sinara-hw/AUX_PSU/README.md

# AUX_PSU
universal, low noise, 3-channel regulated power supply module 

## Design Files

Design files (schematics, PCB layouts, BOMs) can be found at [AUX_PSU/Releases](https://github.com/sinara-hw/AUX_PSU/releases).

## Wiki

More information can be found on the [wiki](https://github.com/sinara-hw/AUX_PSU/wiki).
