sinara-hw/AUX_PSU/(list of files, drawings)

Other design files:
AuxPowerSupply/AuxPowerSupply.PrjPcb
AuxPowerSupply/AuxPowerSupply.SchDoc
AuxPowerSupply/CPCIS_Connectors_P1.SchDoc
AuxPowerSupply/EEM_connector.SchDoc
AuxPowerSupply/Front_PowerConnectors.SchDoc
AuxPowerSupply/Negative_Rail.SchDoc
AuxPowerSupply/OverCurrent_Indicators.SchDoc
AuxPowerSupply/OverTempProtection.SchDoc
AuxPowerSupply/Positive_Rail.SchDoc
AuxPowerSupply/PowerConnectors.SchDoc
