sinara-hw/AUX_PSU/(threads)

Thread 1 (2020-01-10):

[RFC] Aux Power Supply

dtcallcock, 2020-01-10:
In my experience, lab setups rapidly acquire an armada of bench PSUs supplying the same old low voltage DC rails for misc homebrew electronics boxes.  Generally these PSUs are bulky, expensive, have much higher current spec than required, and sometimes have knobs on the front that get accidentally knocked with bad consequences.

It would be nice if there was a simple 3U, 4HP card capable of producing common low-current DC voltage rail combinations.  This board is fairly simple so the main question is probably whether enough people would find it useful and purchase it to make it worth while.

### Inputs
12V - via front panel barrel, rear Molex, and EEM

### Outputs
Voltage rail 1 - selectable between 3.3, 4, 5 and 6V - 1A
Voltage rail 2 - selectable between 5, 9, 12, 15, 18 V - 500mA
Voltage rail 3 - selectable between  -5, -9, -12, -15, -18 V - 500mA

Rotary switches to select voltage on each rail independently.  With a hex switch we can have 16 voltages per rail but a few obvious ones are listed above.

Rails generated using SMPS followed by LDO.

Specs in line with typical decent bench PSU.  Example spec taken from Keysight E3630A as a guide:

Load and line regulation: < 0.01% + 2 mV
Ripple and Noise (20 Hz to 20 MHz): < 350 μVrms, < 1.5 mVpp
Temperature coefficient per C: < 0.02% + 1 mV
Output Drift: Less than 0.1% + 5 mV
Transient response time: < 50 μsec following a change in output current from full load to half load for output to recover within: 15 mV

Overcurrent indicated by LED.  Rail would continue to operate (with no promises on spec) until thermal limit exceeded.  At which point thermal protection LED would come on and board would shut down.

### Connectors
M8-4 - A compact 4-pin connector - could fit 4/5 on panel.

Convenient pigtails [are available](https://www.digikey.com/product-detail/en/phoenix-contact/1406203/277-12862-ND/4291415) for ~$10.  Shielded versions also available for $20.

### Indicators
Overcurrent LED for each rail
Thermal protection LED

Edit: updated this top post to reflect discussion below

michalgaska, 2020-07-14:
I found other LDOs that are more suitable for our project. LT3089 and LT3090.
Both have a programmable current limit and output current monitor. LT3089 has also a junction temperature monitor.
I made output noise simulation for both devices:
LT3089:
There is no spice model for LT3089. Instead of a model for LT3089, I used the LT3081 model which is very similar.
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

LT3090:
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

gkasprow, 2020-07-16:
looks good!
@michalgaska What do you think by "more suitable" ?

gkasprow, 2021-05-22:
finished board
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

jordens, 2021-08-02:
@gkasprow Is this ready for production or has there been a run already?

gkasprow, 2021-08-02:
TS is currently producing it AFAIK

Closed 2021-05-22.

Thread 2 (2020-06-28):

Powering options/EEM

dtcallcock, 2020-06-28:
Options for getting 12V to power the board:

- Barrel connector on the front panel
- Molex connector on the back of the board
- EEM
- PoE

The first two seem like they definitely should.  I think the EEM is worth doing (like on clocker).  I don't think the PoE is, but mention it as it's become pretty standard in Sinara.

If EEM is implemented do we want the following features:
- A diode (ideal diode?) on the 12V line like Clocker to prevent [these kind of issues](https://github.com/sinara-hw/Stabilizer/issues/72).
- The usual EEPROM for identification via I2C (this wasn't done on Clocker).
- An I2C IO extender for monitoring overtemp/overcurrent/pgood etc.
- EEM to be located correctly for the CPCIS adaptor.

gkasprow, 2021-05-22:
I added the ideal diode protection

gkasprow, 2021-05-22:
we also have I2C ADC that monitors temperatures, currents, and voltages.
we don't have LDO PG to monitor.

Closed 2021-05-22.

Thread 3 (2020-07-14):

LDOs

dtcallcock, 2020-07-14:
I found other LDOs that are more suitable for our project. LT3089 and LT3090.
Both have a programmable current limit and output current monitor. LT3089 has also a junction temperature monitor.
I made output noise simulation for both devices:
LT3089:
There is no spice model for LT3089. Instead of a model for LT3089, I used the LT3081 model which is very similar.
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

LT3090:
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

_Originally posted by @michalgaska in https://github.com/sinara-hw/AUX_PSU/issues/1#issuecomment-658224245_

dtcallcock, 2020-07-14:
I made this its own issue to start breaking things out of the original RFC.

Compared to the TPS7A47-Q1, the LT3089 has somewhat worse specs:
- Output voltage noise: 27uVrms vs 4.2uVrms
- PSRR @ switcher freq: 40dB vs 60dB
- Dropout voltage: 1.5V vs 500mV

The latter would increase the power dissipated on this card by a couple of Watts at full draw.

However these aren't show stoppers (noise would still be better than typical bench PSU)  and might be a price worth paying for the convenient current monitor, temp monitor, and  programmable current limit.

gkasprow, 2020-07-16:
How precise is this current monitor? Of course it is simpler than just using the external sense resistor + opamps.

Closed 2021-05-22.

Thread 4 (2020-09-26):

schematic review

gkasprow, 2020-09-26:
- [x] NMOS won't work for a negative rail. Use PMOS + level shifters
- [x] add DC connector (the same as in Thermostat) on the rear edge to not force users to waste EEM slot
- [x] add LC filter between SMPS and LDO, they have not sufficient PSRR for switching frequency
- [x] resistors at the decoder outputs are not needed
- [x] rotate all strings, so the user doesn't need to set the Altium option that does it.
- [x] connect remaining ADC inputs to dividers measuring LDO outputs
- [x] add notes explaining current linit values and LED thresholds
- [x] Front panel LEDs need at least 1mA of current. Use same front panel LEDs current as other designs using same PNs.
- [x] are U sure the negative LDO produces positive ADC_Imon signal?
- [x] now the inactive switch positions result with max output voltages
- [x] use 8-position switches like[ this one](https://www.digikey.com/product-detail/en/S-8011/563-1054-ND/948365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). There is 3D model in Digikey.
- [x] assign all 8 positions, 3V and 6V is often needed. The rest of them must give known value. Place 0R resistors so the user can assign needed value.
- [x] add version with knob or some handle to the BOM. Vendors usually have such accessories, so the user has a choice. Changing the switch settings using a screwdriver will break the switch slot quickly.
- [x] alternatively, one can use [standard](https://pl.mouser.com/ProductDetail/NKK-Switches/NR01105ANG13-2A?qs=EU6FO9ffTwcM3pHNV2SdFA%3D%3D) 1:6 switch, but it would need a tiny RA adapter - a piece of PCB and RA 2.54 connector. But they are nearly 10$ per piece. However, they would last longer.
- [x] apply A3 template with WUT logo
- [x] connect all 3 connectors in the same manner. Place them on the top sheet. They will fit
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

gkasprow, 2020-09-26:
@dtcallcock @jbqubit @hartytp can you have a look at the schematics?
@michalgaska please place a PDF version to make review easier.

dtcallcock, 2020-10-21:
Any joy on the pdf?

jbqubit, 2021-02-26:
What's the status of this board? Searching for a schematic PDF still brings more tears than joy.

gkasprow, 2021-02-26:
@jbqubit here is the schematic. The output connector signal assignment will change.
[Aux_PSU.PDF](https://github.com/sinara-hw/AUX_PSU/files/6052347/Aux_PSU.PDF)

gkasprow, 2021-02-26:
It goes to production together with SHuttler boards

michalgaska, 2021-02-27:
I committed the current design files.
Schematic:
[AuxPowerSupply.pdf](https://github.com/sinara-hw/AUX_PSU/files/6053862/AuxPowerSupply.pdf)

dtcallcock, 2021-03-05:
- It's a bit odd one of the OC LEDs is green, not red.  I guess it would add a BOM line though.

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

- I think it'd be much more useful to have all 3 voltages plus ground on each output connector instead of one voltage on each connector.

- The rear power connector is barrel right now.  I thought the Molex type was the preferred population option for internal power connectors though.

gkasprow, 2021-03-05:
> I think it'd be much more useful to have all 3 voltages plus ground on each output connector instead of one voltage on each connector.
>The rear power connector is barrel right now. I thought the Molex type was the preferred population option for internal power connectors though.
>It's a bit odd one of the OC LEDs is green, not red. I guess it would add a BOM line though.

are you looking at the right schematic? This was fixed some time ago...

dtcallcock, 2021-03-05:
My bad - clicked wrong link above.

- My comment about the Molex still stands though - shouldn't it have a dual footprint like on Stabilizer:
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

- Can we get an annotation about the OC setpoints and programmed regulator current limits?  Right now it looks like the positive rails are set to 600mA limit with 500mA OC threshold but the negative rail is 500mA/500mA.

- As the second positive rail is typically used for V_DD, would 1.8 and 2.5 options be more useful than 15 and 18?  It might be nice to trade the lower voltages for more current in this way too.  Could the limit be raised on this rail if the higher voltages aren't an option?  It looks like going above 800mA would involve paralleling a second LDO so that's perhaps not worth it.

- Why does the temperature sensor only shut off the negative rail?

- Can a 0R be added between the M8-4 shield and ground?  That would allow one to depopulate this if they wanted the shield connected at the load only.  Without being able to see the M8-4 part number, I cannot tell if the shield is likely to be isolated from the front panel.  If it isn't that probably rules this use case out.  However in that case, I think you still want the 0R as you need it to be able to isolate the front panel.

gkasprow, 2021-05-22:
I implemented all suggestions

dtcallcock, 2021-05-24:
Can you make a release with pdf if you have a min?

gkasprow, 2021-05-25:
done

Closed 2021-05-22.

Thread 5 (2021-05-22):

Panel

gkasprow, 2021-05-22:
Here is proposed front panel design
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

dtcallcock, 2021-05-24:
This panel contains there naming conventions -> (+1, +2, -1), (1+, 2+ 1-), and (CH1, CH2, NEG).  Perhaps stick to one?  It's still fairly clear so not a big deal.

Could the labels around the M8-4s be placed at 2, 4, 8, and 10 o'clock around the connector holes such that they actually label the pins?

gkasprow, 2023-02-10:
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

Thread 7 (2021-07-01):

[Schematic review] BCD-2-Decimal decoder floating inputs

mkiepiela, 2021-07-01:
Don't leave the unused D inputs of CD4028 (U3, U4 and U5) floating.
They should be tied to logic Low (N3V3 for U3, GND for U4 and U5).

gkasprow, 2021-07-01:
ACK

Closed 2021-07-01.

Thread 8 (2021-07-01):

[Schematic review] T28 always open

mkiepiela, 2021-07-01:
What is the purpose of T28?
It will be always open, regardless if Kasli is connected or not (P3V3_MP exists or not).

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

gkasprow, 2021-07-01:
It's a voltage translator

mkiepiela, 2021-07-01:
Take a look at this once again, please. It does not look like voltage translator.
P-MOS will be always open. On the En line will be more than 8V (R57/R98 voltage divider additionally pulled up by R64 and LD1D).

gkasprow, 2021-08-18:
Right! There should be NMOS. I didn't notice that PMOS was used instead

Closed 2021-08-18.

Thread 9 (2021-07-01):

[Schematic review] Temperature sensor - to high voltage at O.S. output

mkiepiela, 2021-07-01:
Voltage at O.S. pin of LM75 (IC14) must be less than 6.5V.
It is exceeded. Except R57/R98 voltage divider, this net is also pulled up by R64, LD1D (and open T28).

gkasprow, 2021-07-01:
that's the role of T28 to make sure the rail won't exceed 3V3

mkiepiela, 2021-07-01:
Doesn't seem to work. Details:
https://github.com/sinara-hw/AUX_PSU/issues/8

gkasprow, 2021-08-18:
that should work
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

Closed 2021-08-18.

Thread 10 (2021-08-31):

Stock problems

pkozakiewicz, 2021-08-31:
I would like to address some availability problems:

LT3090HMSE#PBF - can we use different temperature range version? (EMSE, IMSE),
LT8362IDD#TRPBF - same as above (EDD),
LM75AIMM/NOPB - is there any 1:1 replacement?

gkasprow, 2021-08-31:
Yes, you can use another temp range.
LM75BIM-5/NOPB would work

pkozakiewicz, 2021-09-23:
These are another two shortages:

1SMB5916BT3G
3059Y-1-254LF

martafafara, 2024-10-09:
Most of above parts had only temporary stock problems, except LM75AIMM/NOPB which is obsolete. TI recommended replacement: LM75AIMMX/NOPB.
Detailed analysis of BOM revealed additional necessary changes:
CD4028BM-> CD4028BM96
GRM219R61E106KA12D ->TMK212BBJ106KGHT

Closed 2024-10-16.

Thread 11 (2021-12-06):

LT3089IFE schematic symbol - wrong pinout

mkiepiela, 2021-12-06:
Symbol pinout of LT3089IFE (IC4 and IC6) is wrong (pin 16).
As a result, there is a short circuit between input and output of LDOs.

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

Closed 2024-10-09.

Thread 12 (2021-12-06):

LT3089IFE - ILIM pin wrongly connected and resistors wrong values.

mkiepiela, 2021-12-06:
1. ILIM pin has to be connected to OUT instead of GND.
Relates to both, IC4 and IC6.

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

2. Wrong resistors values at ILIM pins. The current limits are set as:
- 580 mA (declared 600 mA),
- 740 mA (declared 800 mA).

Closed 2024-10-15.

Thread 13 (2021-12-06):

LT3089IFE - lack of dummy load - LDO out of regulation

mkiepiela, 2021-12-06:
LT3089IFE requires at least 3 mA of load to work correctly. Without any load the LDOs are out of regulation.

Closed 2024-10-15.

Thread 14 (2021-12-07):

LT3089IFE - wrong values of voltage setting resistors

mkiepiela, 2021-12-07:
All the voltage setting resistors' values at both positive LDOs are wrong (two times to low).

gkasprow, 2023-01-07:
It's not only resistor values that are wrong. The MOSFET Iq causes slight shift and additonal temperature dependence.

gkasprow, 2023-01-07:
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

gkasprow, 2023-01-07:
we can use CSD15380F3

gkasprow, 2023-01-07:
For negative channel we use BSS184 which has followin Idss
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

What's interesting, when I heat the transistor area, the output voltage gets higher by a few mV

gkasprow, 2023-01-07:
The effect I observed was caused by the resistors tempco.

martafafara, 2024-10-15:
Resistors values corected.
Transistors for positive rails are BSS138LT1G. According to datasheet max. leakage current do not exceed 20nA, what gives additional current at the level of 140nA for all transistors on rail. The error level due to Idss is then up to 0,28% what is negligible.
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

Closed 2024-10-15.

Thread 15 (2021-12-09):

LT3089IFE - too high dropout voltage - extra power dissipation

mkiepiela, 2021-12-09:
Dropout voltage at both LDOs is unnecessarily set too high (more than 3.9 V) causing extra power dissipation (even 1.5 - 2 W extra power on each LDO).

According to the LDO spec 2 V would be more than enough.
Set R13/R24 and R18/R14.

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

gkasprow, 2023-01-07:
I added 120k in parallel to R24, R14 and now the dropout is 1.7V

gkasprow, 2023-01-07:
negative LDO is already 2V

gkasprow, 2023-02-07:
we need to leave them 120k

Closed 2024-10-16.

Thread 16 (2021-12-09):

Negative voltage channel - wrong feedback circuit

mkiepiela, 2021-12-09:
Feedback circuit (driving DC/DC voltage level) is wrong designed - no way to work properly.

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

gkasprow, 2021-12-09:
@michalgaska

gkasprow, 2021-12-09:
it should be a pnp + base divider

mkiepiela, 2024-01-22:
Fixed.

Closed 2024-01-22.

Thread 17 (2022-03-30):

production status

jordens, 2022-03-30:
According to @pkozakiewicz the design is pretty much non-functional as it is currently. I think the issues discovered have been filed.
@dtcallcock you were originally pursuing this project. Did you have a look at the board?
@gkasprow is there a way to revise/fix/redesign it?

michalgaska, 2022-03-30:
I am going to fix all the issues with the design.

jordens, 2022-03-30:
That would be great!
Did you manage to rework a v1.0 board to make parts of the design work?

pkozakiewicz, 2022-03-30:
@gkasprow has one board from me and is still working on the fix.

jordens, 2022-05-03:
@michalgaska how is the progress?

jordens, 2022-05-25:
@michalgaska ping

pkozakiewicz, 2022-05-26:
@michalgaska In addition to releasing new revision, please also prepare a patch for existing v1.0 boards.

michalgaska, 2022-05-30:
@jordens I am working on the existing board to fix all the issues. Once I finish that I will make changes to the design.

jordens, 2022-08-23:
@michalgaska How is the work going?

michalgaska, 2022-08-25:
@jordens I fixed all the issues and the board works.  The only thing I need to do is tune the resistor value to have a better over-current indication and check over-temperature protection. Vacation is ending so it is a good time to go back to this project and finish it.

jordens, 2022-09-12:
@michalgaska Thanks for the update! Did you have a chance to look at the issues you described?

jordens, 2022-12-07:
@michalgaska @gkasprow How can we proceed here?

pkozakiewicz, 2022-12-08:
I still have not received a clear instruction what ought to be done with these boards. I count on @michalgaska to send me a detailed description.

jordens, 2022-12-08:
@gkasprow Thanks. Having had a look at the issues for the v1.0 and hearing what @pkozakiewicz said, I'd be very much interested in v1.1 prototypes.

michalgaska, 2022-12-11:
@pkozakiewicz I will prepare it on Monday.

jordens, 2022-12-20:
@michalgaska ping

pkozakiewicz, 2022-12-27:
@gkasprow @michalgaska Any progress here?

gkasprow, 2023-01-07:
I made 2 pieces running.
I tested:
- output voltages switching. I used 250ppm 1% resistors which are probably not sufficient for this purpose
- current limit LEDs
- current limiting
- overtemp protection
- LDO dropout control. It changes +/-20mV  at max load
- ADC input values. I didn't check the I2C readout
- ripples below 10mV, no traces of DC/DC switching signal when no load. Ripples come mostly from ground loop. When full load is applied the ripples are ~10mV and they come from DC/DC converter modulation
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

gkasprow, 2023-01-07:
I added 68nF between C and E of T17 and 1nF in parallel to C43 but the difference is very subtle
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

gkasprow, 2023-01-07:
The output voltage was set to 12V and I used 22Ohm load

gkasprow, 2023-01-07:
Another positive channel has the same issue with DC/DC. Vout=12V, Rl=22Ohm
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

gkasprow, 2023-01-07:
negative LDO does not have such issues
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

gkasprow, 2023-01-07:
It looks like we need an LC filter between DC/DC and LDO. The FB is not suited for this purpose.

gkasprow, 2023-01-07:
Idle power consumption is 60mA

gkasprow, 2023-01-07:
Anyway, the DC/DC converter should not produce such 700mV ripples.

gkasprow, 2023-01-07:
Actually, now the FB of the DC/DC converter is quite complex because it involves LDO transimpedance and also depends on LDO load.

gkasprow, 2023-01-07:
I finished the debugging session for today. The following things to check:
- the negative rail has twice the higher DC/DC converter output capacitance (20uF vs 10uF)
- replace L11 with 2.2uH and add 10uF tantalum parallel to C66 . That would make 23kHz LPF. The FB needs to be there to filter HF components of the DC/DC coverter

jordens, 2023-01-07:
Oh I hadn't noticed that the LDO is inside the SEPIC feedback loop and feedback is for constant dropout. Certainly innovative.

gkasprow, 2023-01-07:
Actually, it's a known technique from AFAIR ADI app note

pkozakiewicz, 2023-01-24:
@gkasprow Any progress here? When should we expect these boards back?

gkasprow, 2023-02-07:
>
>     * the negative rail has twice the higher DC/DC converter output capacitance (20uF vs 10uF)

adding 10uF helped. 47uF did a job.

>
>     * replace L11 with 2.2uH and add 10uF tantalum parallel to C66 . That would make 23kHz LPF. The FB needs to be there to filter HF components of the DC/DC converter

I used 10uH inductor in series with FB. That significantly reduced the ripples.

>
>     * the negative channel 200k FB resistor was not changed

The value is critical because after adding 120k in parallel to 200k the ripples increased significantly.

120k seems to be fine resulting in 2V dropout

Thread 18 (2023-01-01):

layout issues

gkasprow, 2023-01-01:
- [ ] improve GND routing close to L4, L7, L2
- [ ] move switches 0.5mm from the board edge to avoid collision with the panel (THT pins trimming necessary)

gkasprow, 2023-01-07:
- [ ] mark voltage setting resistor and make them 0805

Thread 19 (2023-01-07):

wrong 2.4V divider

gkasprow, 2023-01-07:
R73 and R70 are swapped

Closed 2024-10-14.

Thread 20 (2023-01-07):

OC LEDs have inverted function

gkasprow, 2023-01-07:
swap inputs of the comparators or add MOSFET to drive LEDs

Closed 2024-10-14.

Thread 22 (2023-01-07):

update trimpot values

gkasprow, 2023-01-07:
existing values enable the user to set max 10V

kaolpr, 2023-05-09:
To be exact:
* Negative: -16.3V up to -3.3V
* Positive: **9.0V** up to 18.3V

Closed 2024-10-15.

Thread 23 (2023-02-07):

v1.0 fixes

gkasprow, 2023-02-07:
To make v1.0 usable one needs to implement several fixes:
- cut trace (copper polygon) to pin 16 of IC6 and IC4
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
- cut the trace to via for R99 and R102 and connect to nearby capacitor
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
-add 1k 1206 in parallel to C23 and C40 (for example solder on top of it )
- R104 -> 49k9 0603 10ppm
- R105 -> 36k 0603 10ppm
- R87, R30 -> 240k 0603 or 0805 10ppm
- R89, R31, R59 -> 180k 0603 10ppm
- R39, R60 -> 120k 0603 or 0805 10ppm
- R20,R32 -> 100k 0603 10ppm
- R21 -> 82k 0603 10ppm
- R22, R61 -> 68k 0603 or 0805 10ppm
- R28 -> 360k 1206 10ppm
- R29 -> 300k 0603 10ppm
- R24, R14 -> 120k 0402
- mirror and rotate T15
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
- add 47uF 25V 1206 on top of C37, C66, C20, C67
- add 10uH 1A inductor in series with L12, L11. L10
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
- swap R73 and R70; R73 must be 43k, R70 must be 1.5k

gkasprow, 2023-02-07:
@pkozakiewicz

Thread 24 (2023-05-09):

Current limit for negative rail too high

kaolpr, 2023-05-09:
According to schematics, current limit for negative rail is supposed to be ~600 mA, whereas determined using programmable load is ~750 mA.

Closed 2024-10-14.

Thread 25 (2024-01-15):

iso-SPI

gkasprow, 2024-01-15:
We must build several custom front-ends for photonic sensors, like superconducting nanowire detectors for space-to-ground QKD.
The idea is to reuse this board and add 3 ISO-SPI transceivers and DIOT support.
In this way, with a single AUX_PSU module and primitive AFE boards (just SPI ADC/DAC), we can build a complex system with minimal HW RnD.
So, the idea is to add a mezzanine with [LTC6820](https://www.analog.com/en/products/ltc6820.html), LVDS transceivers, isolation transformers and [SPE connectors](https://www.mouser.pl/ProductDetail/Phoenix-Contact/1163797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).
Is integrating the power supply and isolated digital signals in one M10 connector a good idea?
Alternatively, we could replace M10 with RJ45 connectors and use standard Ethernet cables for power supply and communication.
RJ50(10P10C) could also be a good option to avoid plugging Ethernet or LVDS cable into a 15V supply.

kaolpr, 2024-10-15:
Does this idea still have a use case?

gkasprow, 2025-05-16:
If it's not a problem, we could add a connector and mounting holes for ISO SPI mezzanine, compatible with the ISO_SPI motherboard and route LVDS to the DIOT connector

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

Thread 26 (2024-01-22):

New revision of AUX_PSU - discussion and fix list

mkiepiela, 2024-01-22:
We are going to make new revision of AUX_PSU. Issues to fix:

- [ ] #10
- [ ] #11
- [ ] #12
- [ ] #13
- [ ] #14
- [ ] #15
- [ ] #16
- [ ] #18
- [ ] #19
- [ ] #20
- [ ] #21
- [ ] #22
- [ ] #24

**Feel free to add any suggestions/issues/ideas for new revision.**

gkasprow, 2024-01-22:
make DIOT variant, expose the EEM connector and we will make Iso-SPI mezzanine.

maciejprzybysz, 2024-03-14:
@mkiepiela https://github.com/sinara-hw/AUX_PSU/issues/27

jbqubit, 2024-06-28:
Looking forward to the updated version. :)

martafafara, 2025-04-24:
V2.0 ready to review

gkasprow, 2025-05-16:
There is one remaining issue from my list:
"add 10uH 1A inductor in series with L12, L11, L10"
Ferrite beads are pure resistances at the switcher frequency, and a lot of SEPIC noise goes through the LDO's poor PSRR at that frequency.

martafafara, 2025-05-22:
@gkasprow I haven't seen it before. inductors added.
Additionally, power-up delay circuit added. Removed DIOT part break-off milling. Hole in front of  Molex power connector added for easier plug inserting.

jbqubit, 2025-06-05:
Sounds like this is released for manufacturing! Please create a Release tag on github including PDF schematics, layout and BOM.

Is there a plan for I2C ADC readout support in ARTIQ?

Thread 27 (2024-03-14):

Update power connectors to fit Shuttler

maciejprzybysz, 2024-03-14:
https://github.com/sinara-hw/Shuttler/issues/35

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

martafafara, 2024-10-14:
Introduced in newest revision

Closed 2024-10-14.
