sinara-hw/AUX_PSU/(commit log)

2020-09-26 TODO: connector placement, power polygons, front panel
    [AuxPowerSupply.PrjPcb, AuxPowerSupply.SchDoc, EEM_connector.SchDoc, Negative_Rail.SchDoc, Positive_Rail.SchDoc]
2020-10-21 major modifications from the last issue were applied
    [AuxPowerSupply.SchDoc, EEM_connector.SchDoc, Negative_Rail.SchDoc, Positive_Rail.SchDoc]
2021-02-27 ready to review
    [AuxPowerSupply.PrjPcb, AuxPowerSupply.SchDoc, Negative_Rail.SchDoc, Positive_Rail.SchDoc]
2021-07-01 fixed #7
    [AuxPowerSupply.PrjPcb, AuxPowerSupply.SchDoc]
2021-08-18 v1.0rc2 fixed #8 fixed #9
    [AuxPowerSupply.PrjPcb, AuxPowerSupply.SchDoc, Negative_Rail.SchDoc]
2025-05-22 Added inductors. Power up delay included. No break-off. Hole for molex power plug.
    [AuxPowerSupply.PrjPcb, AuxPowerSupply.SchDoc, CPCIS_Connectors_P1.SchDoc, EEM_connector.SchDoc, Negative_Rail.SchDoc, OverTempProtection.SchDoc, Positive_Rail.SchDoc, PowerConnectors.SchDoc]
